MaxcimChocolate/Lowkey/Hardware/Basic/Bottom/Lowkey-BASIC-BOTTOM-BOM.xlsx

Design Name -- Revision Code / Designer or Organization Name |  |  |  |  |  |  |  |  |  |  | Total | $2.48 | Total (in Bulk) | $1.13
BOM # | Comment | Designator | Description | Mounting Type | Package | Manufacturer | Manufacturer Part Number | Supplier | Supplier Part Number | Price per unit | Quantity | Total | Per 100 | Total
1 | LM358 | OP1 | General Purpose Amplifier 2 Circuit 8-SOIC | SMD | 8-SOIC | Texas Instruments | LM358DR | Digi-Key | 296-1014-1-ND | $0.38 | 1 | $0.38 | $0.14 | $0.14
2 | Photoresistor | Photo | CDS Cell 520nm 27 ~ 60kOhms @ 10 lux | THT | Radial | Advanced Photonix | PDV-P8104 | Digi-Key | PDV-P8104-ND | $0.89 | 1 | $0.89 | $0.46 | $0.46
3 | 9V Battery Connector | 9V | Battery Connector, Snap 9V 1 Cell Wire Leads - 4" (101.6mm) | THT |  | Keystone Electronics | 81-4 | Digi-Key | 36-81-4-ND | $0.55 | 1 | $0.55 | $0.40 | $0.40
4 | White LED | LED1 | White LED Indication - Discrete 2.9V Radial | THT | Radial | American Bright Optoelectronics Corporation | BL-BZX3V4V-1-B02 | Digi-Key | BL-BZX3V4V-1-B02-ND | $0.26 | 1 | $0.26 | $0.09 | $0.09
5 | 10k resistor | R1,R2,R3 | 10 kOhms ±1% 0.1W, 1/10W Chip Resistor 0603 (1608 Metric) Automotive AEC-Q200 Thick Film | SMD | 0603 | Stackpole Electronics Inc | RMCF0603FT10K0 | Digi-Key | RMCF0603FT10K0CT-ND | $0.10 | 3 | $0.30 | $0.01 | $0.02
6 | 1uF capacitor | C1 | 1µF ±10% 25V Ceramic Capacitor X5R 0603 (1608 Metric) | SMD | 0603 | Samsung Electro-Mechanics | CL10A105KA8NNNC | Digi-Key | 1276-1102-1-ND | $0.10 | 1 | $0.10 | $0.02 | $0.02
