MaxcimChocolate/Lowkey/(commit log)

2020-07-01 Organized Repo
    [LowKey-BASIC-TOP.brd, LowKey-BASIC-TOP.sch, Lowkey-BASIC-BOTTOM-BOM.xlsx, Lowkey-BASIC-BOTTOM.brd, Lowkey-BASIC-BOTTOM.sch, Lowkey-BASIC-PPG-MODULE-BOM.xlsx, Lowkey-BASIC-PPG-MODULE.brd, Lowkey-BASIC-PPG-MODULE.sch]
2020-07-08 Added basic top board elements
    [LowKey-BASIC-TOP.brd, LowKey-BASIC-TOP.sch]
2020-07-09 Top connections
    [LowKey-BASIC-TOP.brd, LowKey-BASIC-TOP.sch]
2020-07-13 Take 4 Routing Top Board 17 min
    [LowKey-BASIC-TOP.brd, LowKey-BASIC-TOP.sch]
2020-07-14 Take 4 Complete
    [LowKey-BASIC-TOP.brd, LowKey-BASIC-TOP.sch]
2020-07-14 added arduino project
2020-07-14 Copied PPG and Bottom Boards in
    [KickJr-Basic-BOTTOM.brd, KickJr-Basic-BOTTOM.sch, KickJr-PPG-Module-BOM.xlsx, KickJr-PPG-Module.brd, KickJr-PPG-Module.sch]
2020-07-14 Fixed deleted files
    [Lowkey-BASIC-BOTTOM.brd, Lowkey-BASIC-BOTTOM.sch, Lowkey-BASIC-PPG-MODULE-BOM.xlsx, Lowkey-BASIC-PPG-MODULE.brd, Lowkey-BASIC-PPG-MODULE.sch]
2020-07-28 Take 06
    [LowKey-BASIC-TOP.brd, LowKey-BASIC-TOP.sch]
2020-07-28 Take 7
    [LowKey-BASIC-TOP.brd, LowKey-BASIC-TOP.sch]
2020-07-29 Finished routing top board
    [LowKey-BASIC-TOP.brd, LowKey-BASIC-TOP.sch]
